pixelcircuits/LEDCube/pcb/PCB_Main.png

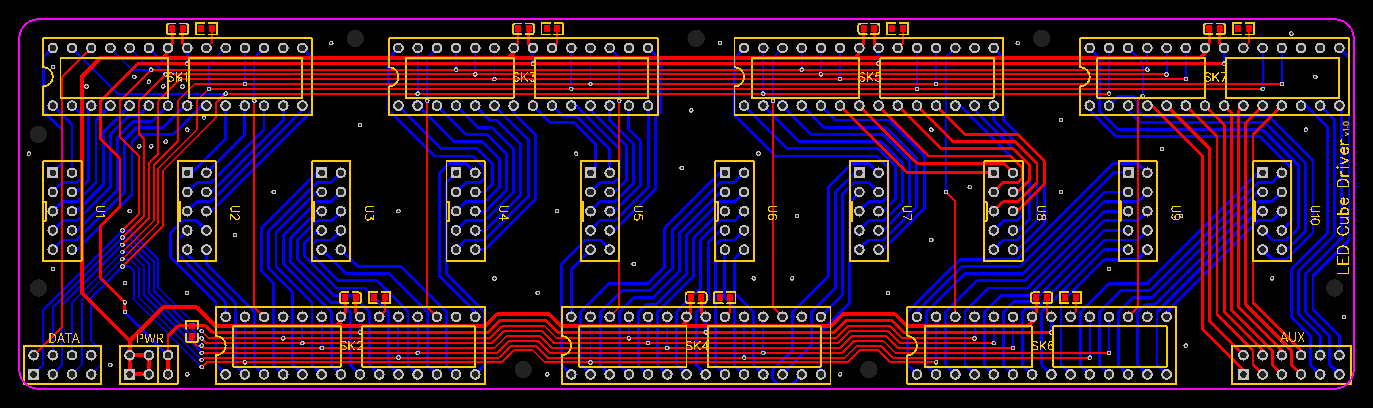
pcb/PCB_Main.png
