pixelcircuits/LEDCube/pcb/PCB_Power.png

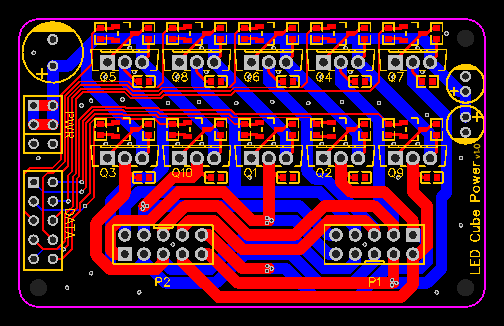
pcb/PCB_Power.png
