pixelcircuits/LEDCube/pcb/Schematic.png

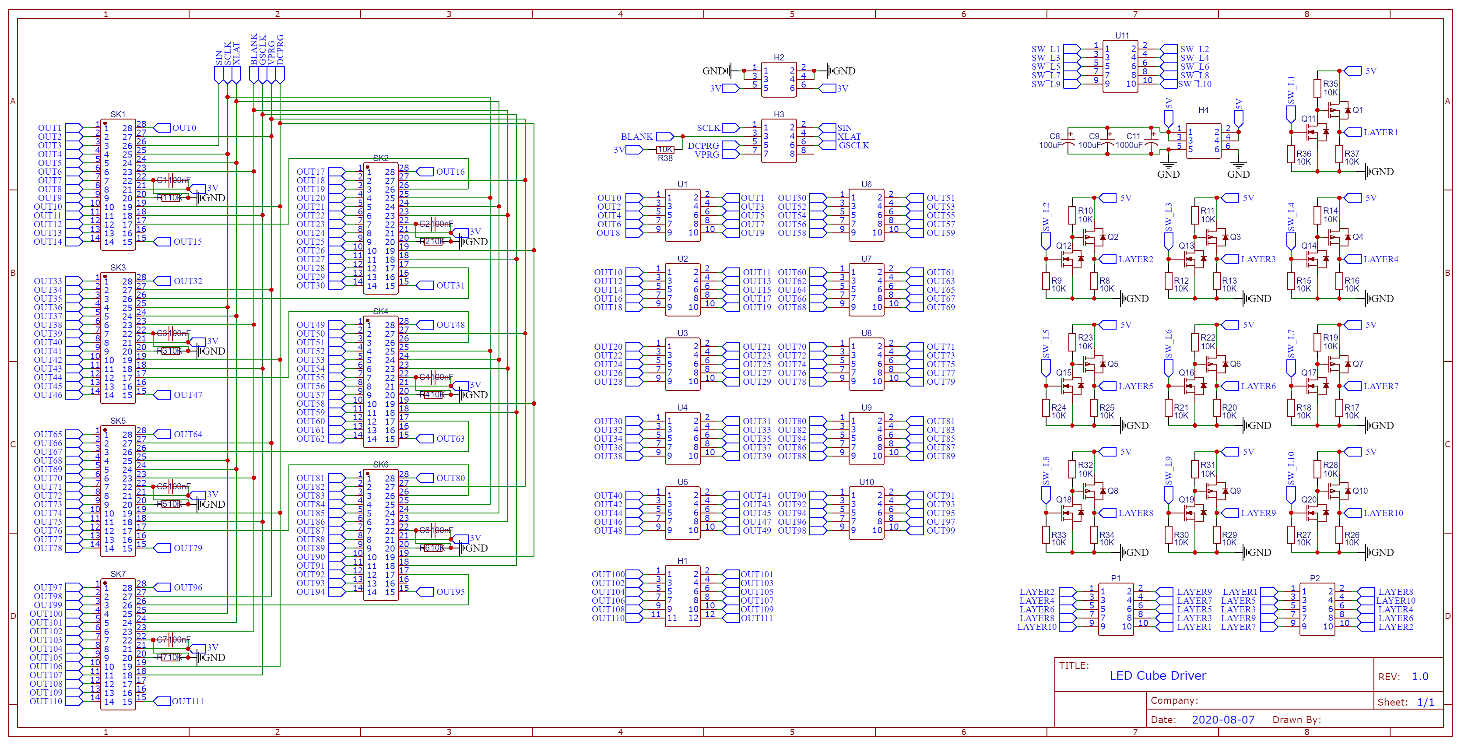
pcb/Schematic.png
