pixelcircuits/LEDCube/pcb/timings.png

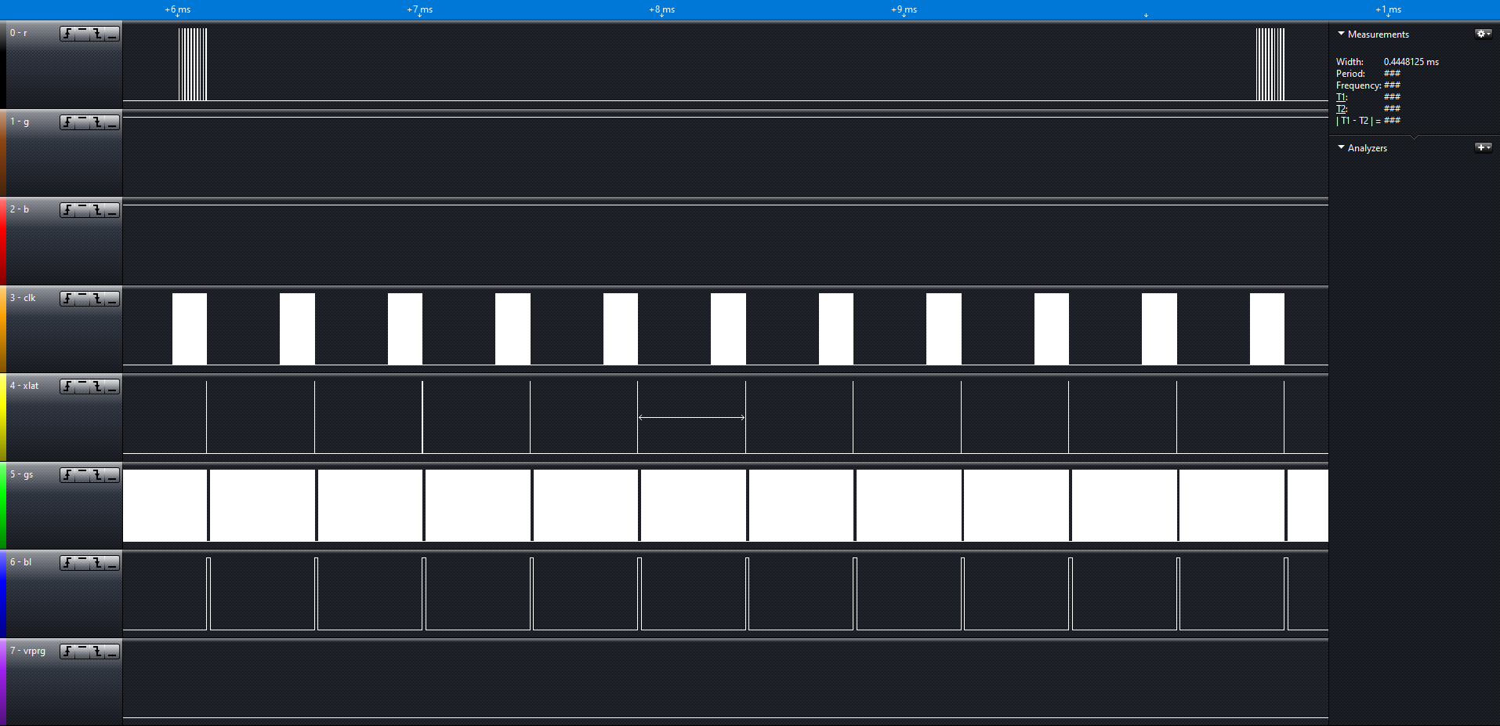
pcb/timings.png
