pixelcircuits/LEDCube/(commit log)

2020-11-27 Added pcb details
2020-11-27 added spi summary
